jani-onct/CH32X035G8U6_ColorCAN/kicad/IRC27_ColorCAN_v1.0.0.kicad_pcb

## KiCad design kicad/IRC27_ColorCAN_v1.0.0.kicad_pcb (2026-11-12)

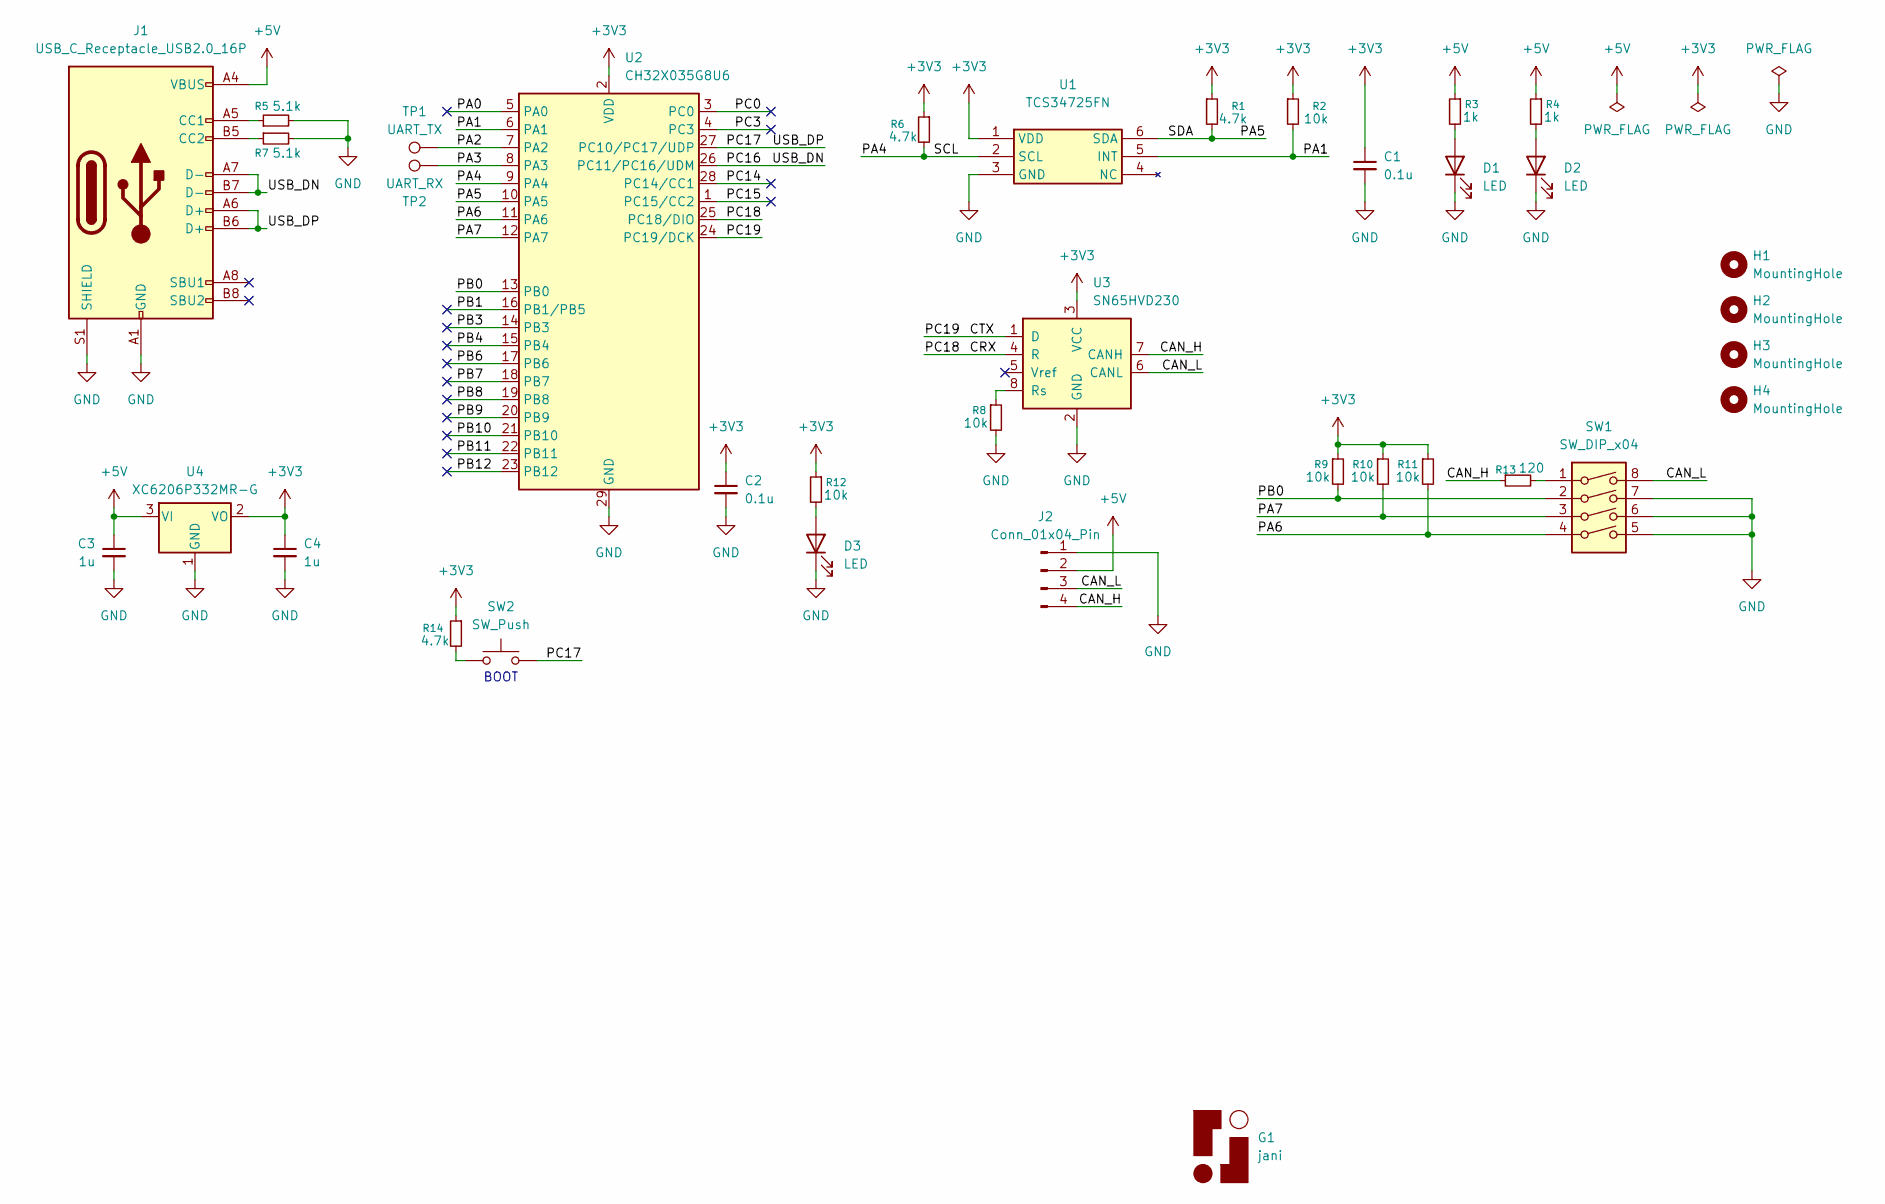
[picture p6: schematic IRC27_ColorCAN_v1.0.0.kicad_sch]

Parts:
C1, C2: 0.1u; C_0603_1608Metric
C3, C4: 1u; C_0603_1608Metric
D1, D2, D3: LED; LED_0603_1608Metric
G1: jani; jani_rogo_mini
H1, H2, H3, H4: MountingHole; MountingHole_3.2mm_M3
J1: USB_C_Receptacle_USB2.0_16P; USB_C_Receptacle_HRO_TYPE-C-31-M-12
J2: Conn_01x04_Pin; JST_XA_S04B-XASK-1_1x04_P2.50mm_Horizontal
R1, R6, R14: 4.7k; R_0402_1005Metric
R2, R8, R9, R10, R11, R12: 10k; R_0402_1005Metric
R3, R4: 1k; R_0402_1005Metric
R5, R7: 5.1k; R_0402_1005Metric
R13: 120; R_0603_1608Metric
SW1: SW_DIP_x04; SW_DIP_SPSTx04_Slide_KingTek_DSHP04TS_W7.62mm_P1.27mm
SW2: SW_Push; SW_Push_SPST_NO_Alps_SKRK
TP1: UART_TX; TestPoint_Pad_D1.0mm
TP2: UART_RX; TestPoint_Pad_D1.0mm
U1: TCS34725FN; Manufacturer_Part_Number TCS34725FN; Mouser Part Number 985-TCS34725FN
U2: CH32X035G8U6; WQFN-28-1EP_4x4mm_P0.4mm_EP2.7x2.7mm
U3: SN65HVD230; SOIC-8_3.9x4.9mm_P1.27mm
U4: XC6206P332MR-G; SOT-23-3

Connections:
+3V3: C1.1, C2.1, C4.1, R1.1, R2.1, R6.1, R9.1, R10.1, R11.1, R12.1, R14.1, U1.1 (VDD), U2.2 (VDD), U3.3 (VCC), U4.2 (VO)
+5V: C3.1, J1.A4 (VBUS), J1.A9 (VBUS), J1.B4 (VBUS), J1.B9 (VBUS), J2.2, R3.1, R4.1, U4.3 (VI)
/CAN_H: J2.4, R13.1, U3.7 (CANH)
/CAN_L: J2.3, SW1.8, U3.6 (CANL)
/CRX: U2.25 (PC18/DIO), U3.4 (R)
/CTX: U2.24 (PC19/DCK), U3.1 (D)
/PA0: U2.5 (PA0)
/PA1: R2.2, U1.5 (INT), U2.6 (PA1)
/PA2: TP1.1, U2.7 (PA2)
/PA3: TP2.1, U2.8 (PA3)
/PA4: R6.2, U1.2 (SCL), U2.9 (PA4)
/PA5: R1.2, U1.6 (SDA), U2.10 (PA5)
/PA6: R11.2, SW1.4, U2.11 (PA6)
/PA7: R10.2, SW1.3, U2.12 (PA7)
/PB0: R9.2, SW1.2, U2.13 (PB0)
/PB1: U2.16 (PB1/PB5)
/PB3: U2.14 (PB3)
/PB4: U2.15 (PB4)
/PB6: U2.17 (PB6)
/PB7: U2.18 (PB7)
/PB8: U2.19 (PB8)
/PB9: U2.20 (PB9)
/PB10: U2.21 (PB10)
/PB11: U2.22 (PB11)
/PB12: U2.23 (PB12)
/PC0: U2.3 (PC0)
/PC3: U2.4 (PC3)
/PC14: U2.28 (PC14/CC1)
/PC15: U2.1 (PC15/CC2)
/PC16: J1.A7 (D-), J1.B7 (D-), U2.26 (PC11/PC16/UDM)
/PC17: J1.A6 (D+), J1.B6 (D+), SW2.2, U2.27 (PC10/PC17/UDP)
GND: C1.2, C2.2, C3.2, C4.2, D1.1 (K), D2.1 (K), D3.1 (K), J1.A1 (GND), J1.A12 (GND), J1.B1 (GND), J1.B12 (GND), J1.S1 (SHIELD), J2.1, R5.2, R7.2, R8.2, SW1.5, SW1.6, SW1.7, U1.3 (GND), U2.29 (GND), U3.2 (GND), U4.1 (GND)
unnamed: D1.2 (A), R3.2
unnamed: D2.2 (A), R4.2
unnamed: D3.2 (A), R12.2
unnamed: J1.A5 (CC1), R5.1
unnamed: J1.B5 (CC2), R7.1
unnamed: R13.2, SW1.1
unnamed: R14.2, SW2.1
unnamed: R8.1, U3.8 (Rs)

Notes on the sheet:
BOOT

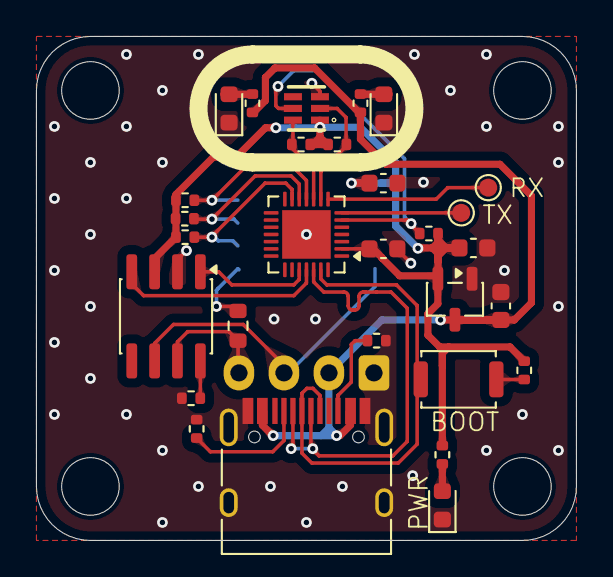
[picture p7: board IRC27_ColorCAN_v1.0.0.kicad_pcb from above]

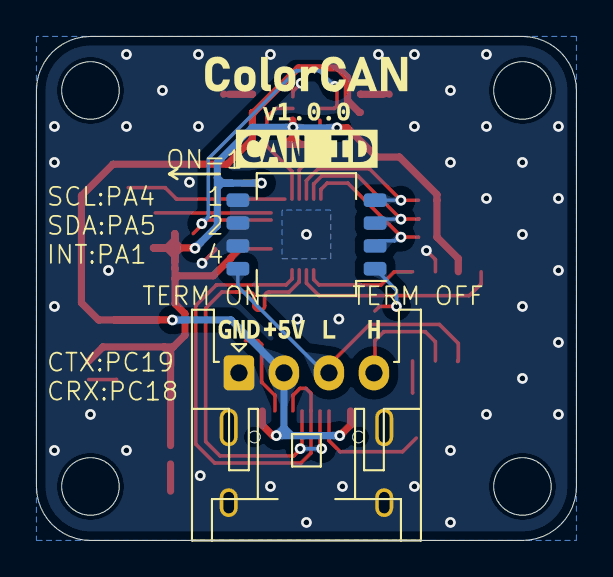
[picture p8: board IRC27_ColorCAN_v1.0.0.kicad_pcb from below]

Board: 2 copper layers, 30.0 x 28.0 mm, 36 parts (2 on the bottom side), 25 nets.
