jani-onct/CH32X035G8U6_ColorCAN/(commit log)

2026-11-12 Document ColorCAN mounting hole spacing
2026-11-12 Add ColorCAN schematic and board dimensions
2026-11-12 Show DIP settings and CAN frame examples
2026-11-12 Refresh ColorCAN 3D views from current PCB
2026-11-12 Publish KiCad sources and standalone ColorCAN documentation
    [IRC27_ColorCAN_v1.0.0.kicad_pcb, IRC27_ColorCAN_v1.0.0.kicad_sch]
2026-11-12 Publish ColorCAN Arduino PIOC firmware and build sources
